leonardsaers/3d-printable-telescope/images/keplerian-telescope.png

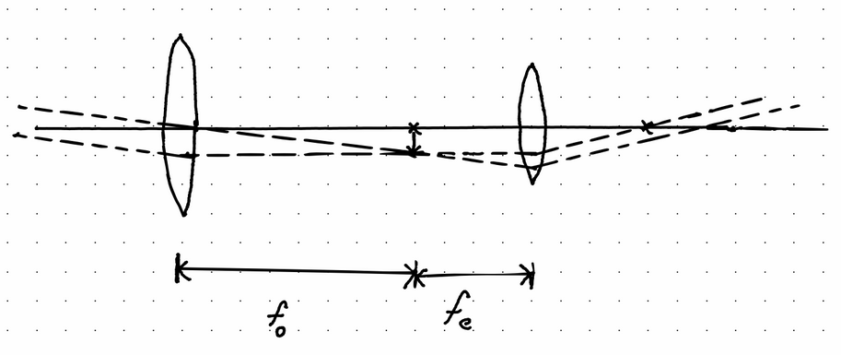
images/keplerian-telescope.png
