leonardsaers/3d-printable-telescope/images/objective.png

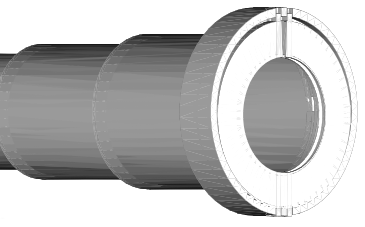
images/objective.png
