leonardsaers/3d-printable-telescope/images/optical_tube.png

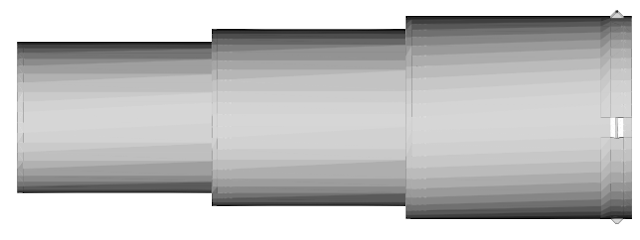
images/optical_tube.png
