leonardsaers/3d-printable-telescope/images/poor-mans-telescope-mounted.png

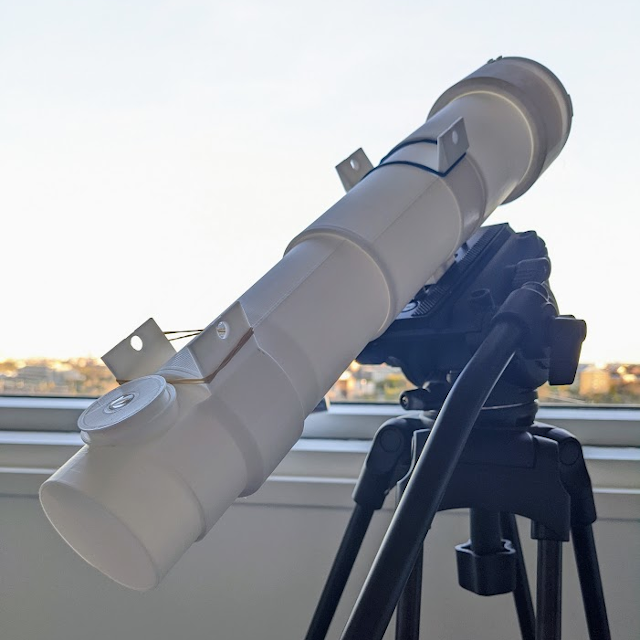
images/poor-mans-telescope-mounted.png
