leonardsaers/3d-printable-telescope/the-poor-mans-telescope-tube.FCStd

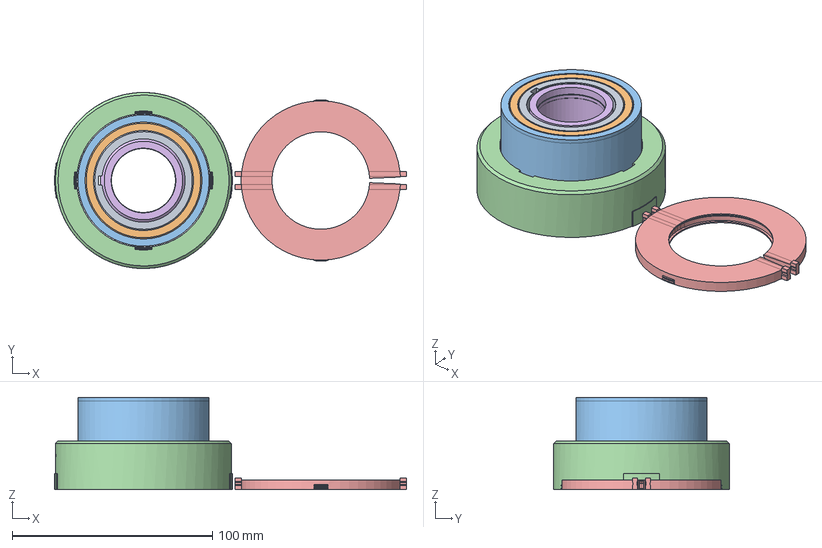
[picture p9: CAD file, 2024-12-12]
the-poor-mans-telescope-tube.FCStd
175.9 x 88.0 x 46.1 mm
tube-first-section
tube-second-section
tube-third-section
objective
objective_lens_holder
focuser-tube
