leonardsaers/3d-printable-telescope/the-poor-mans-telescope-stabilize.FCStd

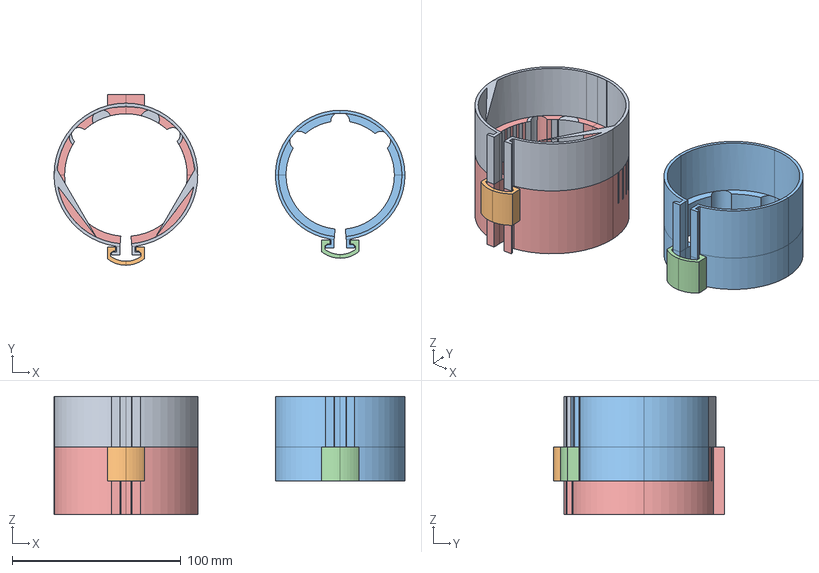
[picture p10: CAD file, 2024-11-23]
the-poor-mans-telescope-stabilize.FCStd
208.0 x 101.1 x 70.0 mm
