leonardsaers/3d-printable-telescope/the-poor-mans-telescope-focuser.FCStd

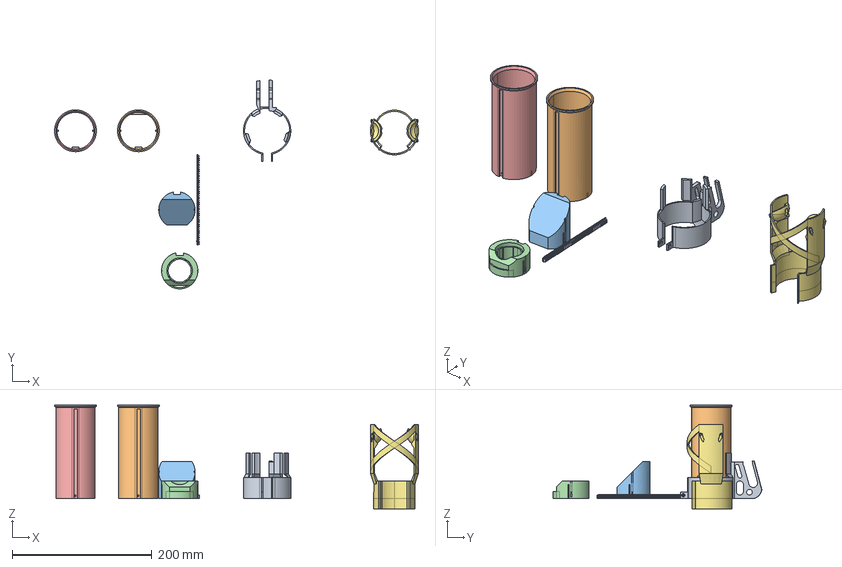
[picture p11: CAD file, 2023-11-15]
the-poor-mans-telescope-focuser.FCStd
520.4 x 298.5 x 148.6 mm
Focuser-tube
