leonardsaers/3d-printable-telescope/the-poor-mans-telescope-eyepiece.FCStd

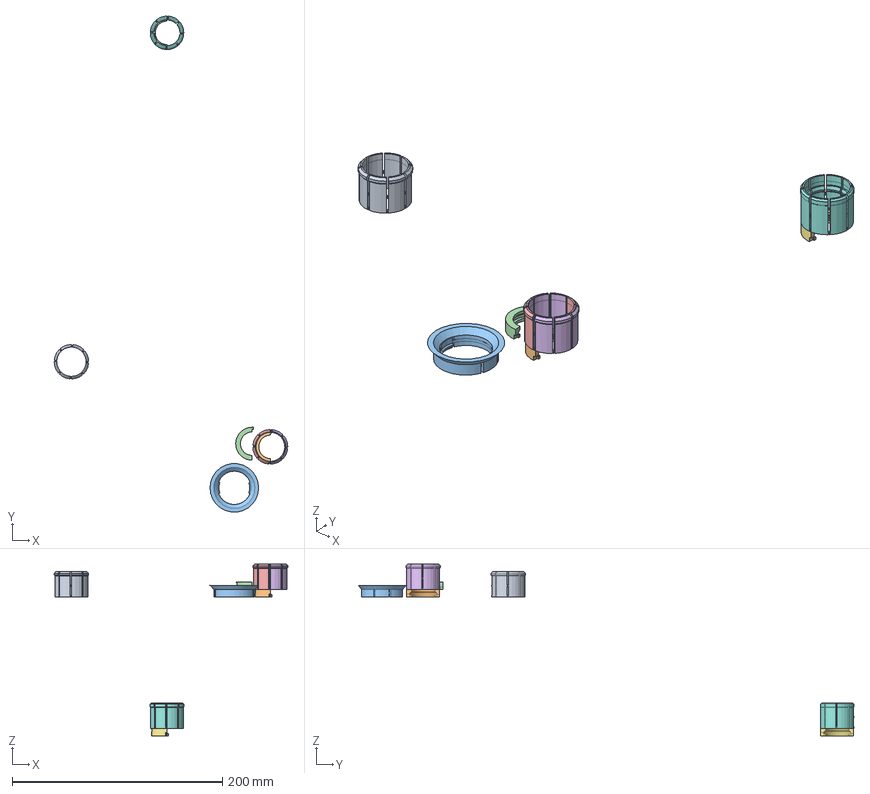
[picture p12: CAD file, 2023-05-09]
the-poor-mans-telescope-eyepiece.FCStd
222.4 x 472.0 x 163.4 mm
eye-piece-base
