leonardsaers/3d-printable-telescope/images/poor-mans-telescope-print.png

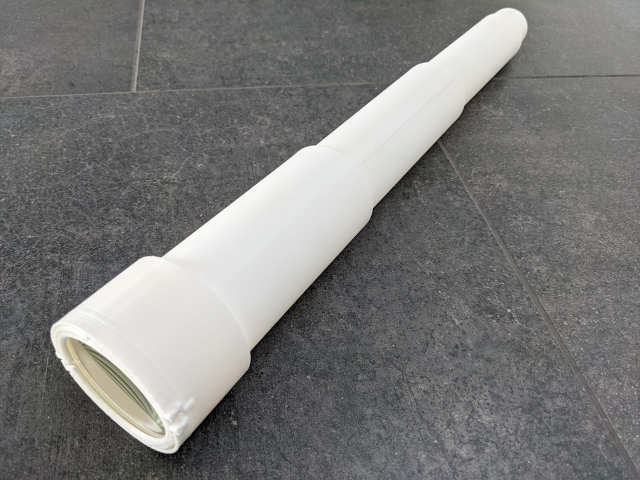
images/poor-mans-telescope-print.png
