leonardsaers/3d-printable-telescope/images/print-in-place-telescope.png

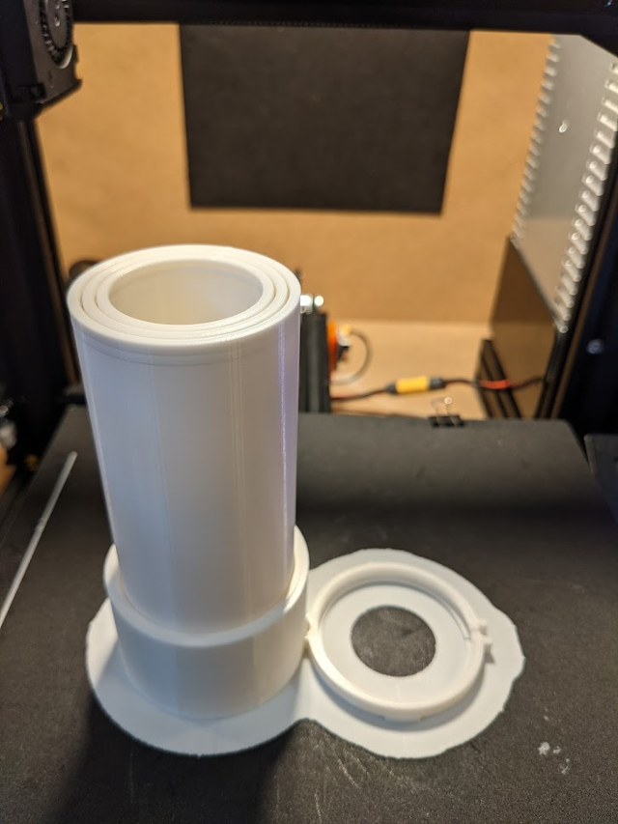
images/print-in-place-telescope.png
