leonardsaers/3d-printable-telescope/(commit log)

2021-09-01 First printable prototype of the telescope
    [kikare.FCStd]
2021-09-11 New objective for the telescope
    [kikare.FCStd]
2021-09-24 Add stopping part to objective so that the lens should not fall out
    [kikare.FCStd]
2021-09-26 Added the bodies to parts
    [kikare.FCStd]
2021-09-29 Allow for objective lens to be both wider and smaller than tube
    [kikare.FCStd]
2021-10-10 Adust length of tube in order to match specified focal lengths
    [kikare.FCStd]
2021-10-16 Minor tweaks on the telescope
    [kikare.FCStd]
2021-10-16 Rename Freecad file to the-poor-mans-telescope.FCStd
    [the-poor-mans-telescope.FCStd]
2021-10-17 FIX adjust tube length due to wrong focal length was initially used for eyepiece
    [the-poor-mans-telescope.FCStd]
2021-12-02 FIX increase eypiece outher radius to match tube
    [the-poor-mans-telescope.FCStd]
2021-12-29 minor tweaks in order to strengthen fragile areas
    [the-poor-mans-telescope.FCStd]
2022-01-06 move focal point of objective outside tube
    [the-poor-mans-telescope.FCStd]
2022-01-09 minor adjustment to tube
    [the-poor-mans-telescope.FCStd]
2022-01-30 Add 1/4-20 mount connection
    [the-poor-mans-telescope.FCStd]
2022-04-02 Adjust tripod mount parts and update README.md
    [the-poor-mans-telescope.FCStd]
2022-05-10 Add focal tube that supports standard size eyepieces
    [the-poor-mans-telescope.FCStd]
2022-07-29 Add a focuser knob which can be used to calibrate the focuser tube
    [the-poor-mans-telescope.FCStd]
2022-08-22 add structure for newtonian secondary mirror with size 25 mm
    [the-poor-mans-telescope.FCStd]
2022-10-03 Separate the focuser to own freecad file
    [the-poor-mans-telescope-focuser.FCStd]
2022-12-22 Break out the parts into different files, and recreation of the focuser tube
    [the-poor-mans-telescope-focuser.FCStd, the-poor-mans-telescope-stabilize.FCStd, the-poor-mans-telescope-tube.FCStd, the-poor-mans-telescope.FCStd]
2023-01-10 Update the focuser and prepare it to handle two gears
    [the-poor-mans-telescope-focuser.FCStd]
2023-01-19 minor change on objective
    [the-poor-mans-telescope-tube.FCStd]
2023-02-12 Adjust so that focuser tube will stay fixed and not rotate
    [the-poor-mans-telescope-focuser.FCStd, the-poor-mans-telescope-tube.FCStd]
2023-02-12 Add wip part that will be a eye piece
    [the-poor-mans-telescope-tube.FCStd]
2023-02-24 Add a standard size eypepiece
    [the-poor-mans-telescope-tube.FCStd]
2023-02-26 Add separate project for the eyepiece
    [the-poor-mans-telescope-eyepiece.FCStd]
2023-03-03 Remake the simpel focuser tube to fit a 1.25 inch eyepiece
    [the-poor-mans-telescope-eyepiece.FCStd, the-poor-mans-telescope-tube.FCStd]
2023-03-12 FIX length of focuser tube so that it adapts to focal length
    [the-poor-mans-telescope-tube.FCStd]
2023-03-17 add imag for optical tube and objective
2023-03-27 minor adjustmnts
    [the-poor-mans-telescope-eyepiece.FCStd, the-poor-mans-telescope-tube.FCStd]
2023-03-27 Update markdown in preparation for release
    [the-poor-mans-telescope.FCStd]
2023-05-09 add model of eyepiece that uses a concave lens
    [the-poor-mans-telescope-eyepiece.FCStd]
2023-11-15 Add support for a more precise focuser tube
    [the-poor-mans-telescope-focuser.FCStd, the-poor-mans-telescope-stabilize.FCStd, the-poor-mans-telescope-tube.FCStd]
2024-11-09 improved the lens holder to twist into place instead of being pushed
    [the-poor-mans-telescope-tube.FCStd]
2024-11-10 FIX heigth of objective was not specified
    [the-poor-mans-telescope-tube.FCStd]
2024-11-20 Update the tube ring design so that it only uses 3d-printed parts
    [the-poor-mans-telescope-stabilize.FCStd]
2024-11-23 Reconstructed the part that connects the telescope to the mount so that the part only contains 3d-printed parts
    [the-poor-mans-telescope-stabilize.FCStd]
2024-12-12 finetune the tube
    [the-poor-mans-telescope-tube.FCStd]
